AndrejChoo/portable_programmer/README.md

# portable_programmer

Устройство представляет из себя портативный программатор (а точнее - его макет, собранный из модулей), который хранит прошивки для записи и считанные данные с программируемых микросхем памяти на SD карте.
Я называю устройство макетом, так как оно не является в полной мере автономным, не имеет схемы зарядки и питания от аккумулятора, а также потому что собрано из готовых модулей на соединительной плате, что обуславливает довольно большие размеры конечного устройства. Хотя межет успешно использоваться совместно с power-банком.

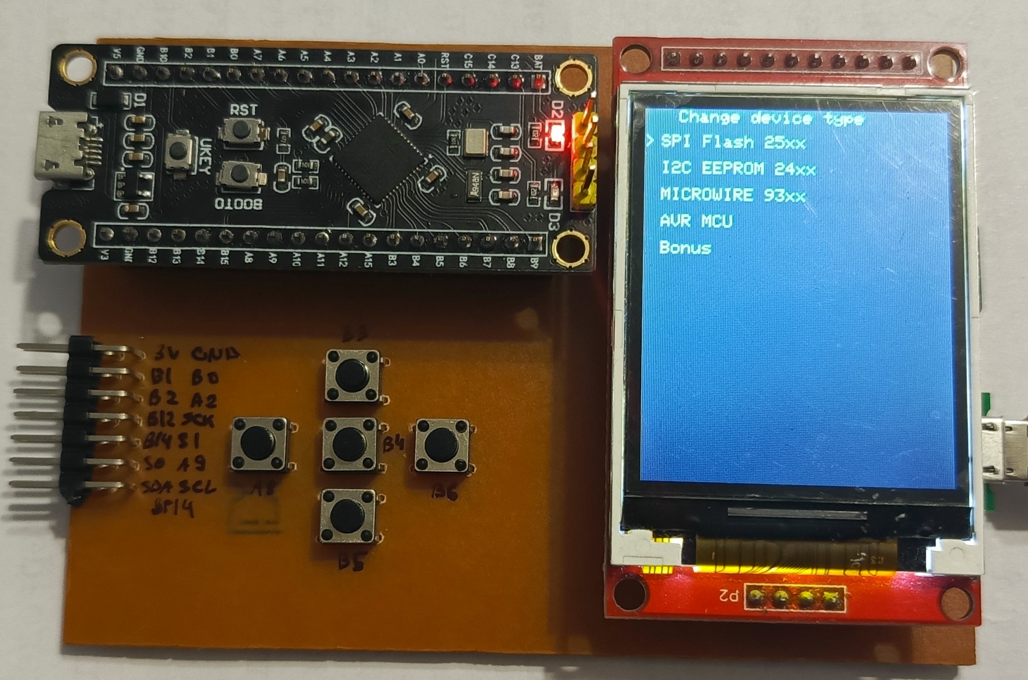
[picture p1: hardware/Board_Up.jpg]
view


Как видно, устройство собрано на многим известной плате Black pill с STM32F411CEU на борту. Она имеет достаточно большие объёмы Flash и SRAM (что достаточно критично при создании устройств с графическим, даже текстовым интерфейсом), имеет интерфейс SDIO (что очень сильно облегчает работу с чипом при использовании CubeMX и увеличивает скорость чтения/записи SD карты), а также может программироваться через встроенный USB разъём, так как имеет USB-bootloader.

В качестве дисплея использован готовый недорогой модуль разрешением 176х220 точек на базе ili9225, управляемый по SPI. При желании можно переписать код на внешне идентичный дисплей на базе ST7735, только нужно будет добавить библиотеку работы с данным дисплеем.

Разъём MicroSD карты распаян на соединительной плате (см. фото нижней стороны платы).

Графический интерфейс реализован в виде текстового меню. Управление устройства реализовано с помощью пяти кнопок (Up,Down,Left,Right,Set). 

Общение с внешней средой (то есть с программируемыми чипами) осуществляется с помощью разъёма 7х2 пин, на который выведено питание, SPI4 (mosi,miso,sck), I2C1 (scl, sda) и несколько GPIO. 

На данный момент реализована и проверена работа со: SPI Flash 25хх (по 25хх128 включительно, работу 25хх128 и 25хх256 добавлю в процессе отладки); I2C EEPROM 24хх; Microwire EEPROM 93xx серии; AVR8 микроконтроллерами (добавлено только несколько моделей, список можно расширить в файле "avr_devs.h").

Для работы с файлами полноценного файлового менеджера устройство не имеет, имена файлов выводятся по очереди в одну строку. Используются файлы только корневого католога флешки. Включена поддержка длинных имён файлов, но не рекомендую использовать слишком длинные имена, так как используется только полторы строки дисплея для отображения имён.
При чтении прошивки в файл можно изменять название файла из 8 символов с помощью кнопок устройства.

Для программирования можно использовать только бинарные файлы (расширение не имеет значения). Если попытаться записать HEX файл, то просто запишется текст файла в виде последовательности байт (букв). Встроенного HEX2BIN конвертера нет, поэтому HEX файлы необходимо сконвертировать заранее.

Подключение внешних микросхем памяти к разъёму следующее: SPI Flash DO->miso, DI->mosi, CLK->sck, CS->PB12; I2C EEPROM SCL->scl, SDA->sda; Microwire EEPROM DO->PB1, DI->PB0, CLK->PB2, CS->PA2; AVR MOSI->PB0, MISO->PB1, SCK->PB2, RST->PB12.

Проект для CubeIDE находится в папке "source", можно легко адаптировать для других камней STM32 (например, Black pill на STM32F401, STM32L серию или многих других, так как 99% кода инициализации написано на HAL), а если немного приложить усилий, можно переписать и на другие камни с достаточным объёмом Flash памяти (какой-нибудь RP2040, правда придётся переписать драйвер SD карты на SPI и объединить линии SPI для дисплея, карты и внешнего разъёма).

Если кому-то понравилось данное устройство, не поленитесь поставить звёздочку.
