AndrejChoo/portable_programmer/hardware/adapter.jpg

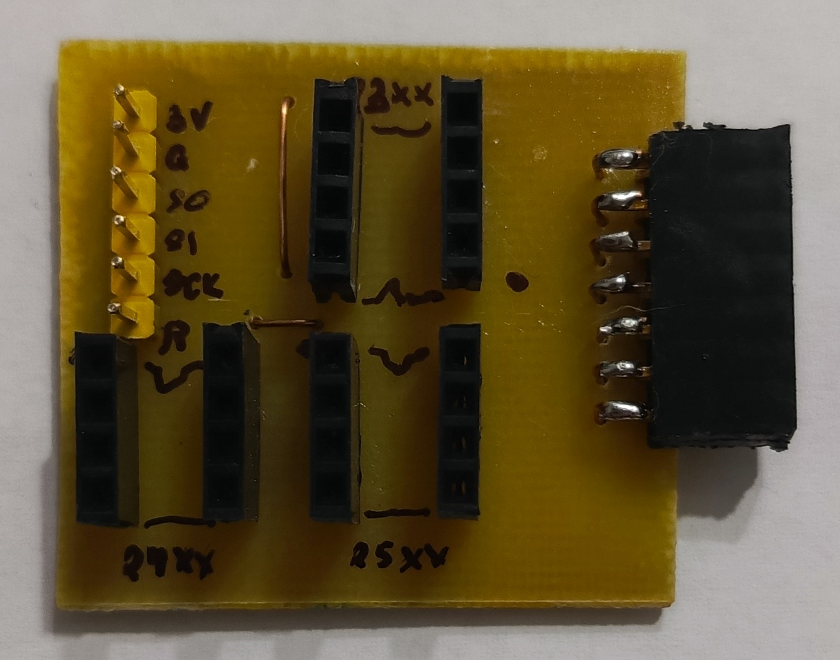
hardware/adapter.jpg
