AndrejChoo/portable_programmer/hardware/Board_Down.jpg

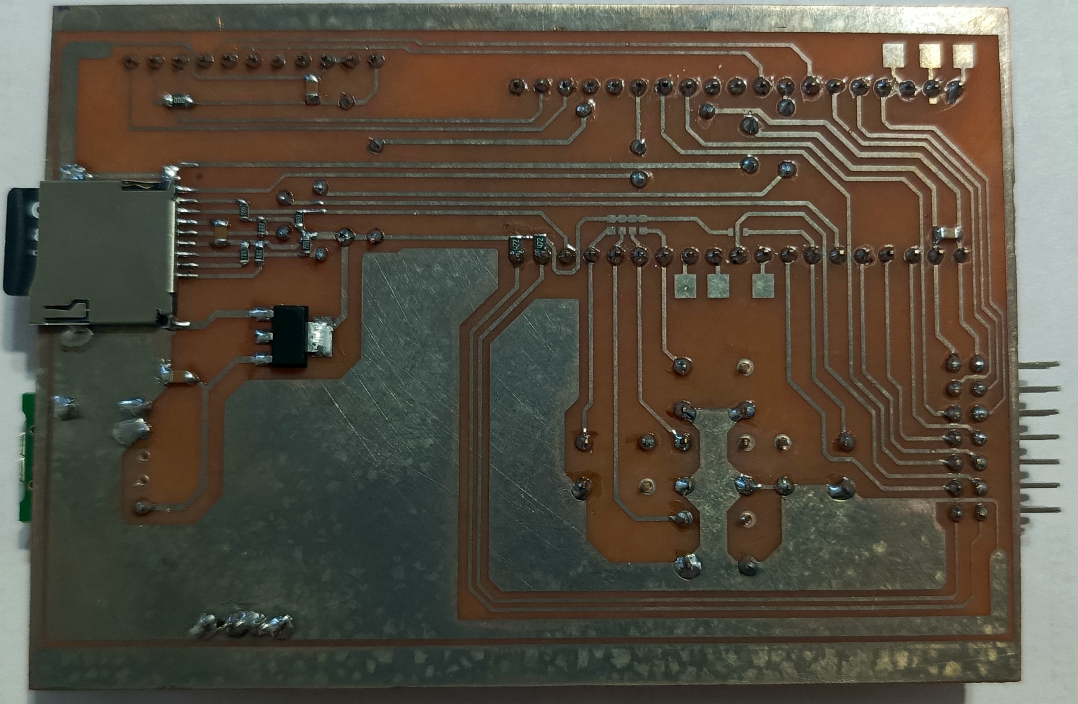
hardware/Board_Down.jpg
