AndrejChoo/portable_programmer/hardware/Progger_with_adapter.jpg

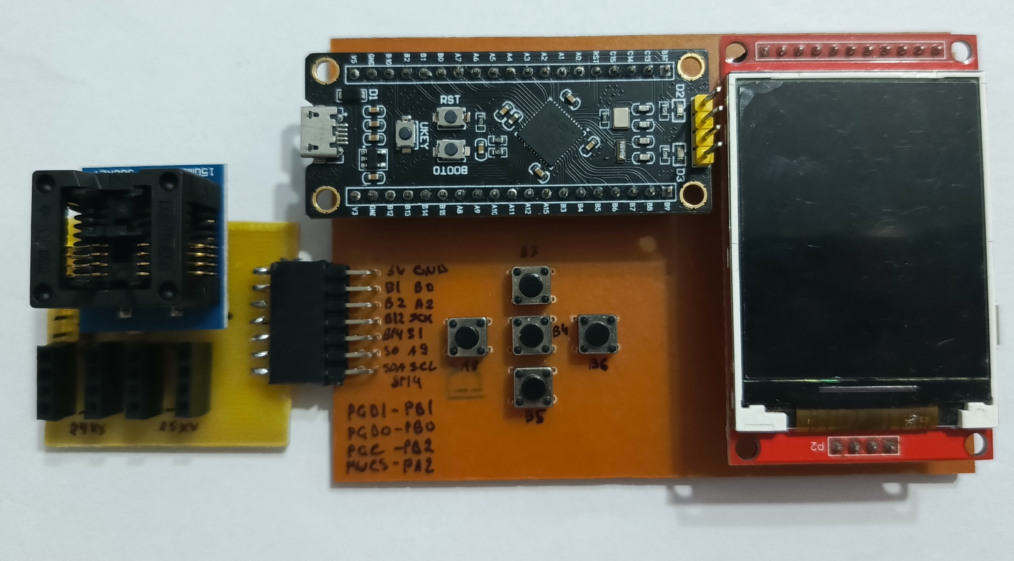
hardware/Progger_with_adapter.jpg
