AndrejChoo/portable_programmer/hardware/Schematic_PortableProg.png

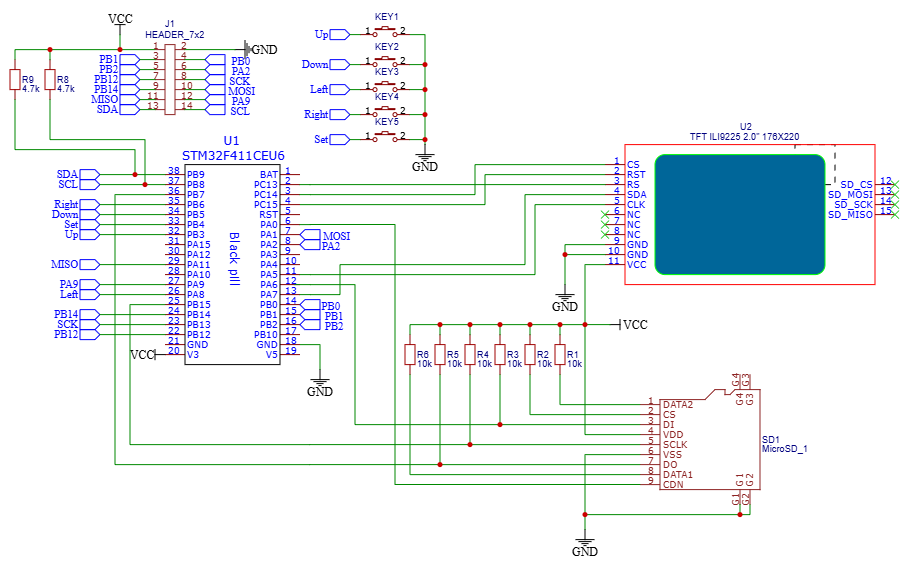
hardware/Schematic_PortableProg.png
