AndrejChoo/portable_programmer/hardware/Schematic_PortableProg.pdf

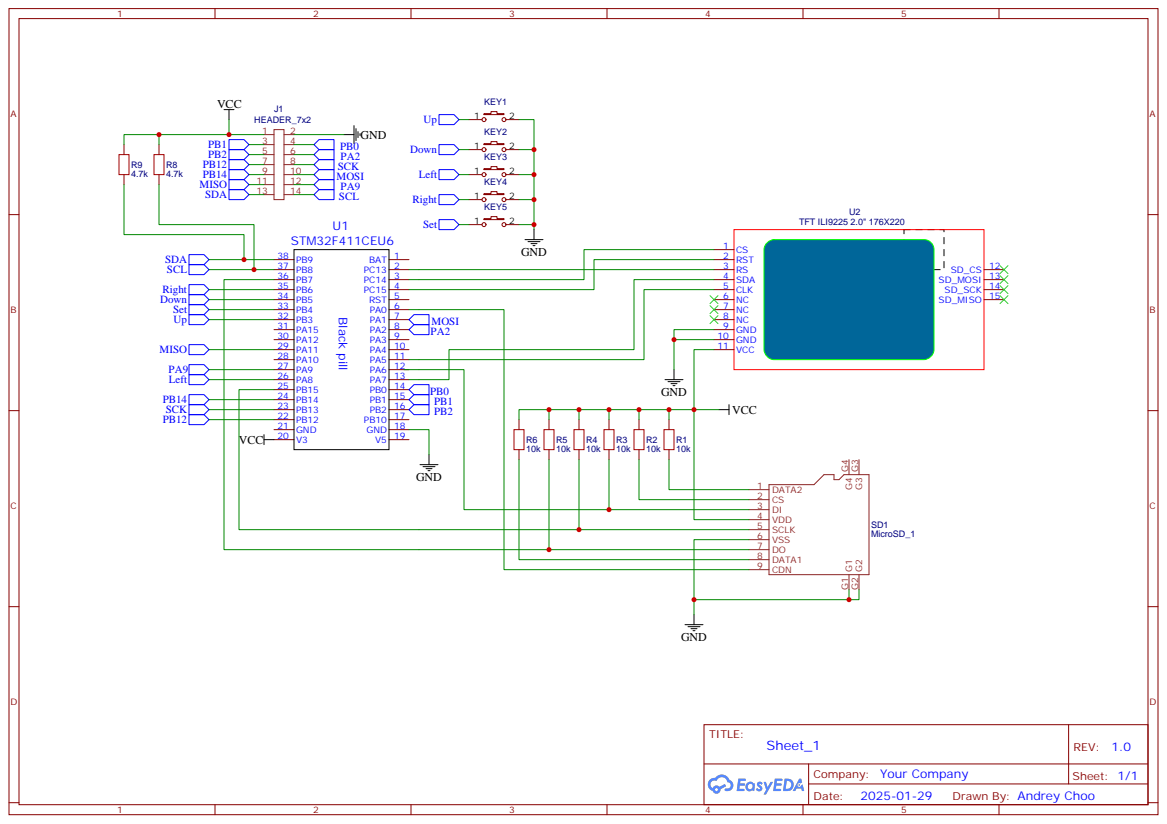
[picture p6: page 1]

Drawn By: Andrey Choo
