AndrejChoo/portable_programmer/(list of files, drawings)

Other design files:
hardware/Portable_prog.lay6
hardware/Portable_prog_Adapter.lay6
